zebgop-ops/quadbot/sim/runs/cat/slopes_speed_efficiency.png

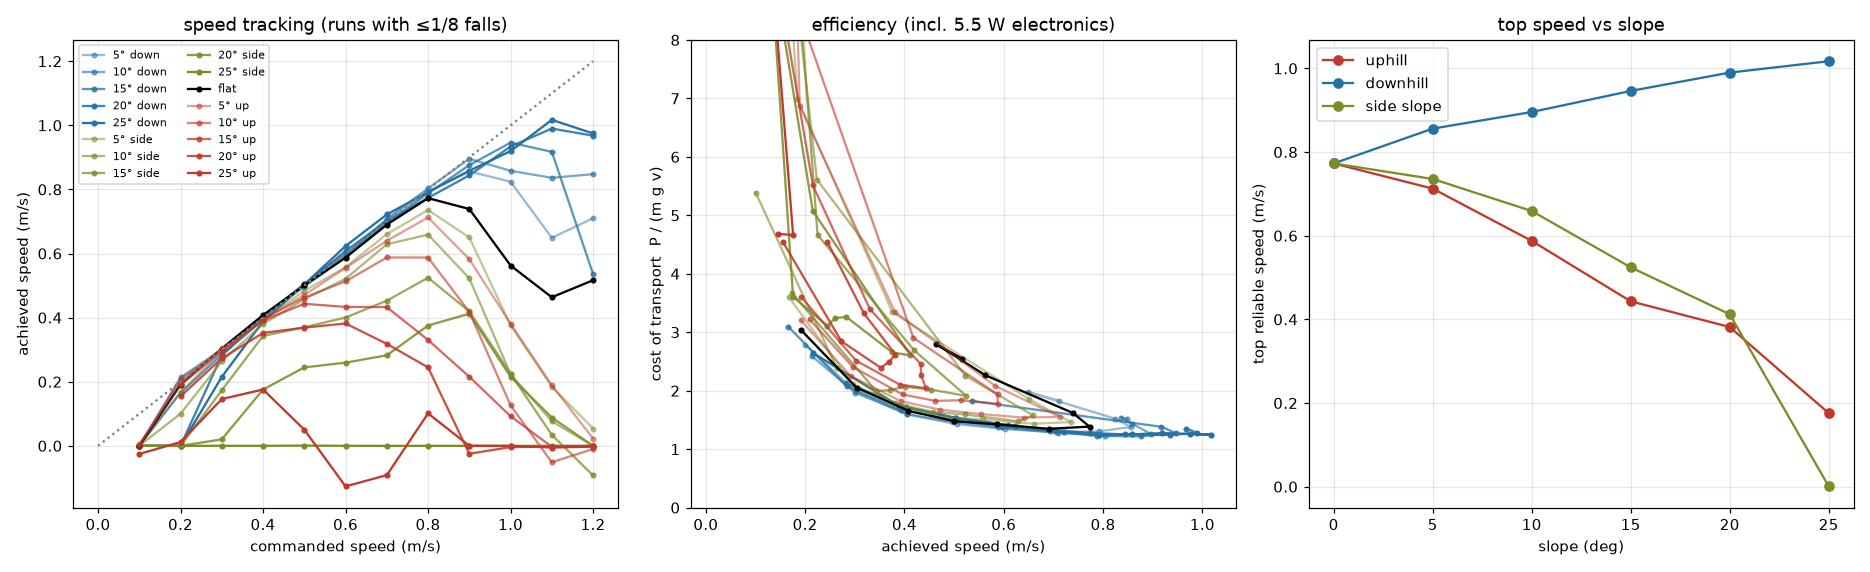
sim/runs/cat/slopes_speed_efficiency.png
