zebgop-ops/quadbot/sim/runs/cat_final/hills_speed_efficiency.png

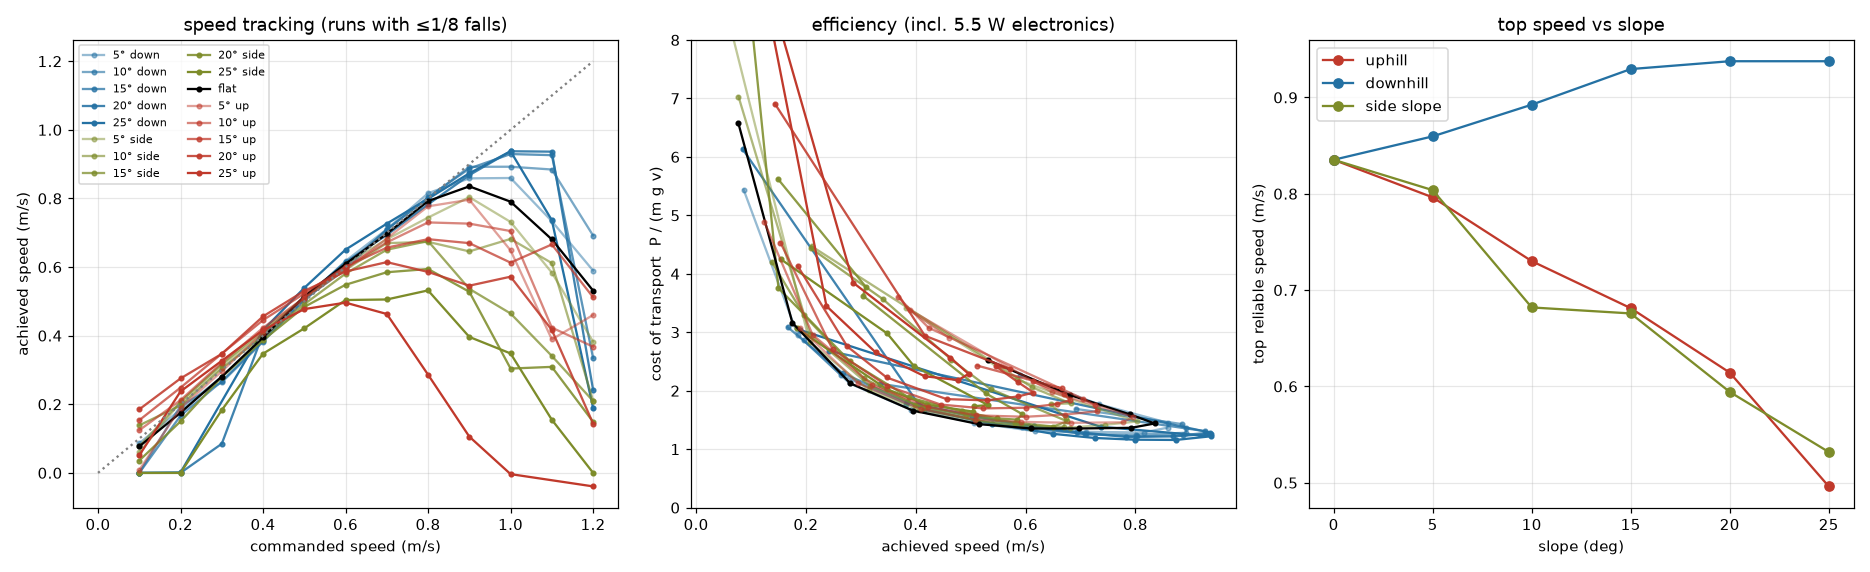
sim/runs/cat_final/hills_speed_efficiency.png
