zebgop-ops/quadbot/sim/quadbot_description/meshes/LR_hip.stl

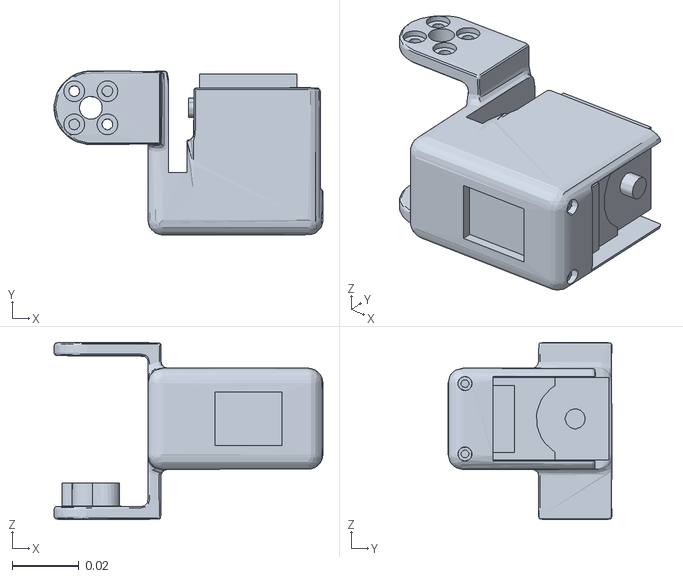
[picture p10: CAD file, 2026-10-11]
sim/quadbot_description/meshes/LR_hip.stl
0.0803 x 0.049 x 0.0529
