zebgop-ops/quadbot/stl/tibia_right.stl

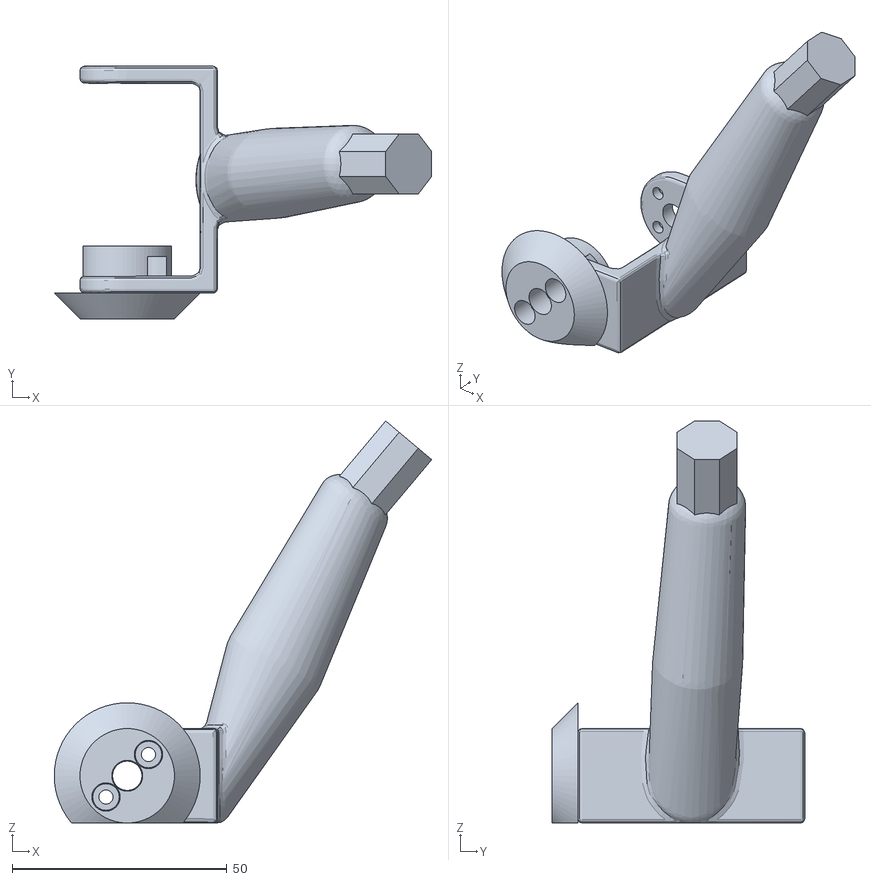
[picture p11: CAD file, 2026-10-11]
stl/tibia_right.stl
87.9 x 58.9 x 93.6
