zebgop-ops/quadbot/sim/quadbot_description/meshes/LF_thigh.stl

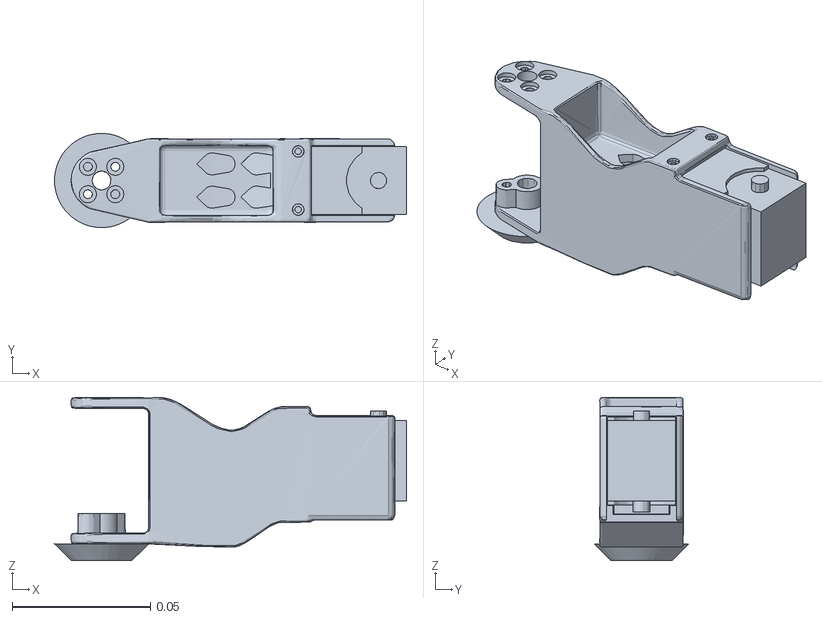
[picture p12: CAD file, 2026-10-11]
sim/quadbot_description/meshes/LF_thigh.stl
0.127 x 0.034 x 0.0589
