zebgop-ops/quadbot/stl/hump.stl

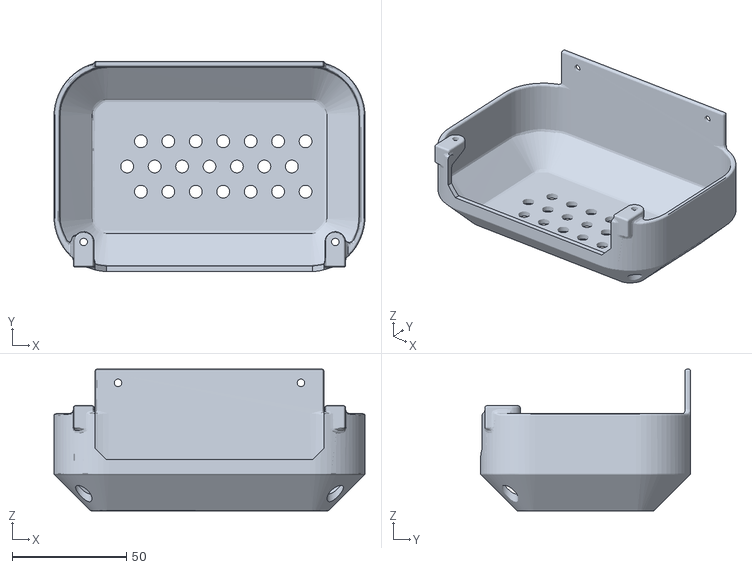
[picture p13: CAD file, 2026-10-11]
stl/hump.stl
136.0 x 92.0 x 62.0
