zebgop-ops/quadbot/stl/foot_left.stl

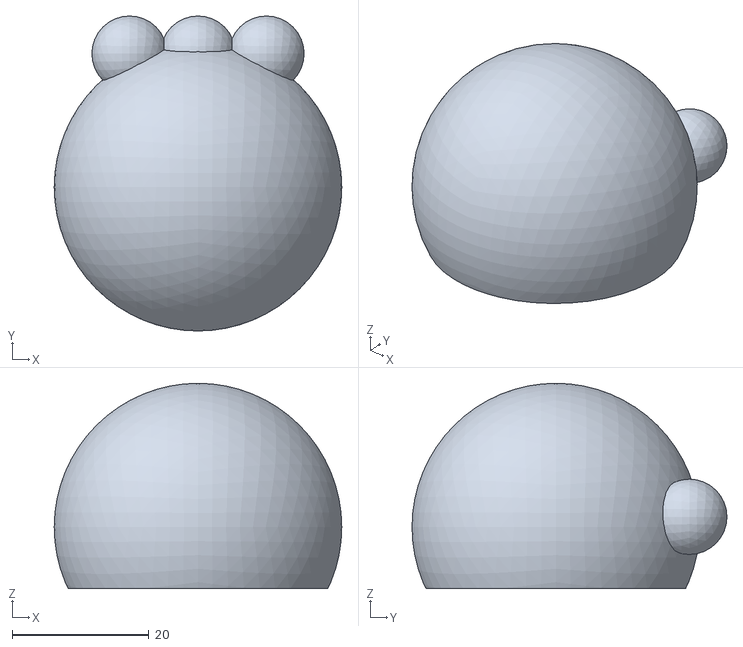
[picture p14: CAD file, 2026-10-11]
stl/foot_left.stl
42.0 x 46.0 x 30.0
