zebgop-ops/quadbot/sim/quadbot_description/meshes/RR_calf.stl

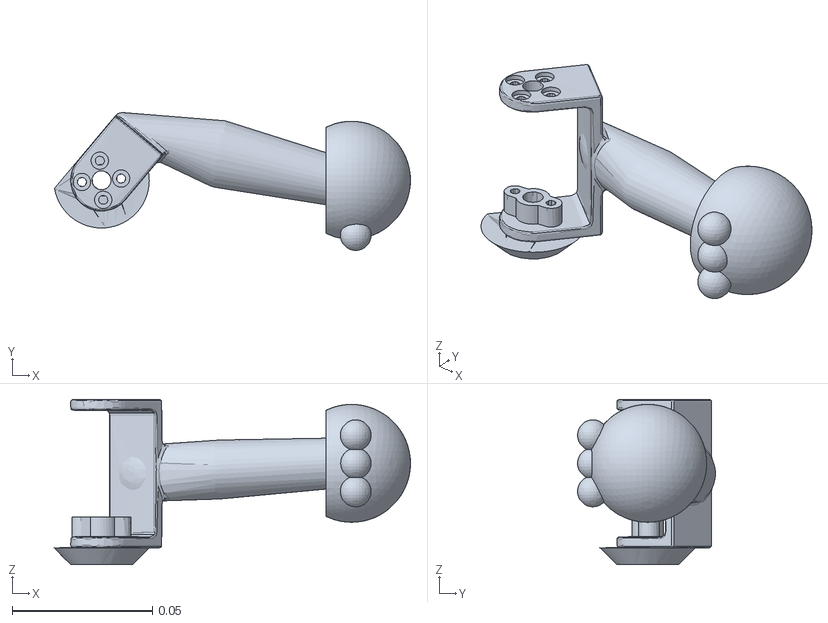
[picture p15: CAD file, 2026-10-11]
sim/quadbot_description/meshes/RR_calf.stl
0.127 x 0.0491 x 0.0589
