zebgop-ops/quadbot/stl/ear_cap.stl

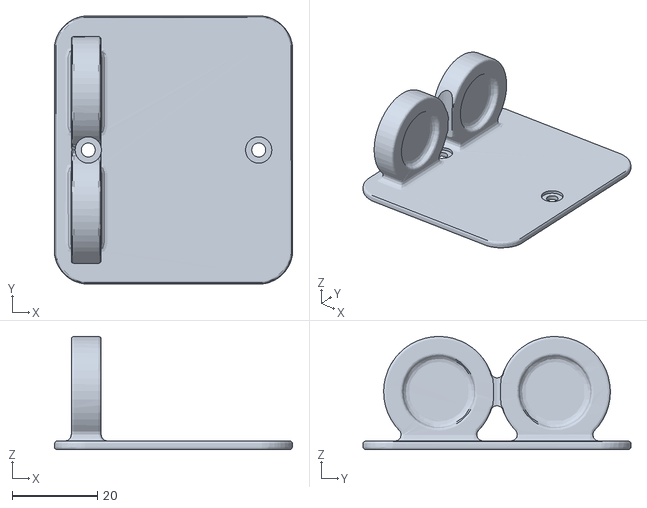
[picture p16: CAD file, 2026-10-11]
stl/ear_cap.stl
55.9 x 62.9 x 26.5
