zebgop-ops/quadbot/stl/neck_base.stl

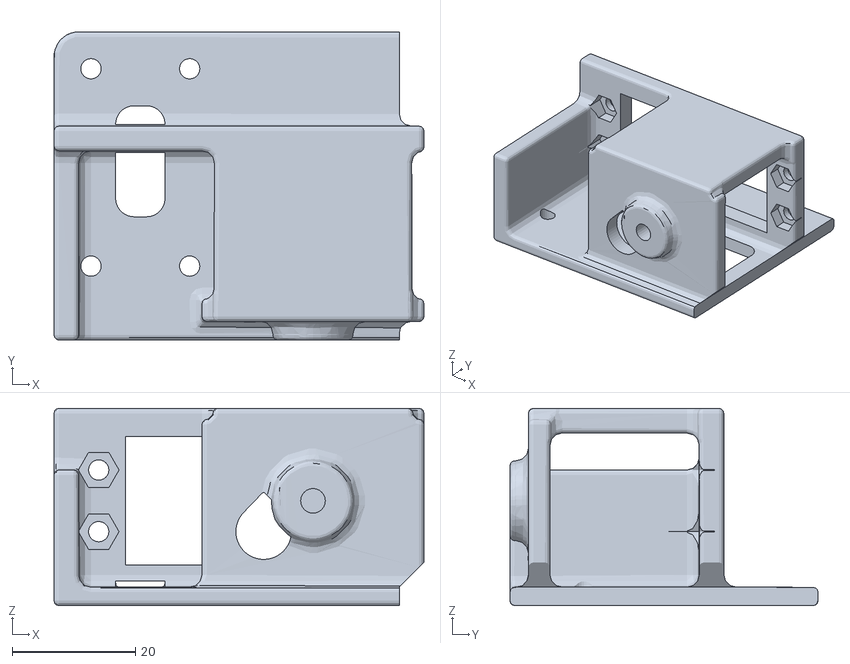
[picture p17: CAD file, 2026-10-11]
stl/neck_base.stl
60.0 x 50.0 x 32.0
