zebgop-ops/quadbot/stl/head.stl

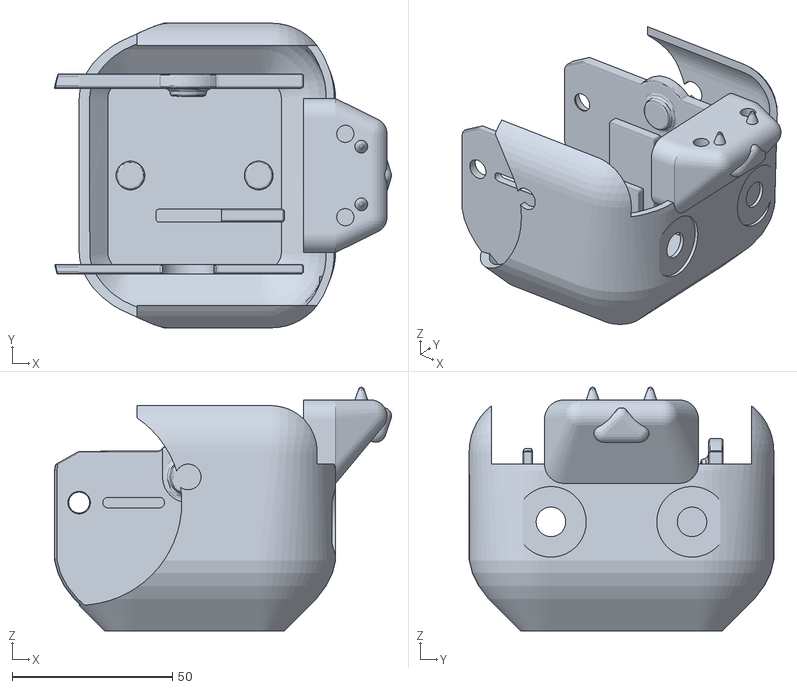
[picture p18: CAD file, 2026-10-11]
stl/head.stl
105.1 x 95.0 x 76.0
