zebgop-ops/quadbot/stl/stand.stl

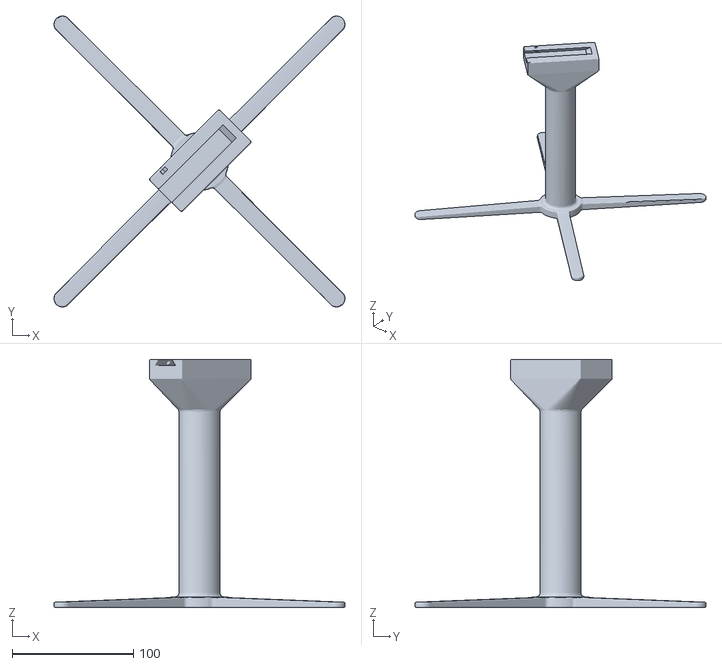
[picture p19: CAD file, 2026-10-11]
stl/stand.stl
240.2 x 240.2 x 205.0
