zebgop-ops/quadbot/stl/fit_test_cradle.stl

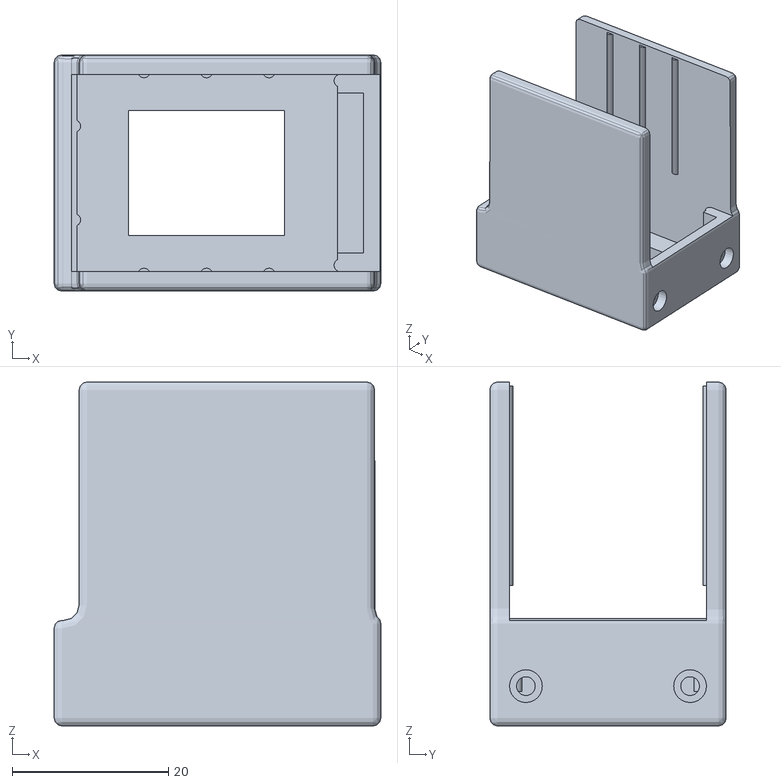
[picture p20: CAD file, 2026-10-11]
stl/fit_test_cradle.stl
41.8 x 30.2 x 44.0
