zebgop-ops/quadbot/stl/jaw.stl

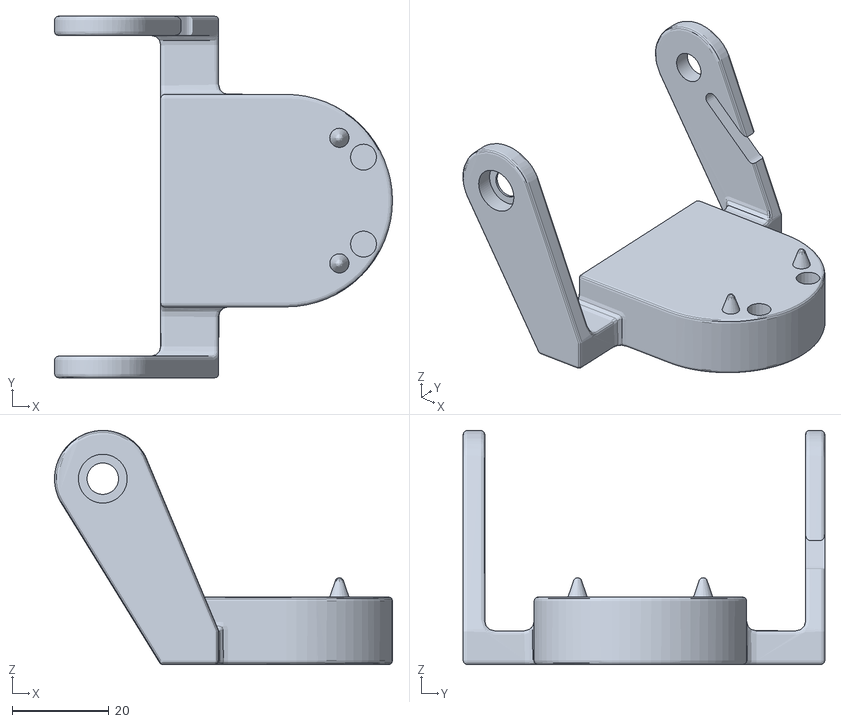
[picture p21: CAD file, 2026-10-11]
stl/jaw.stl
70.0 x 74.9 x 48.5
