zebgop-ops/quadbot/stl/femur.stl

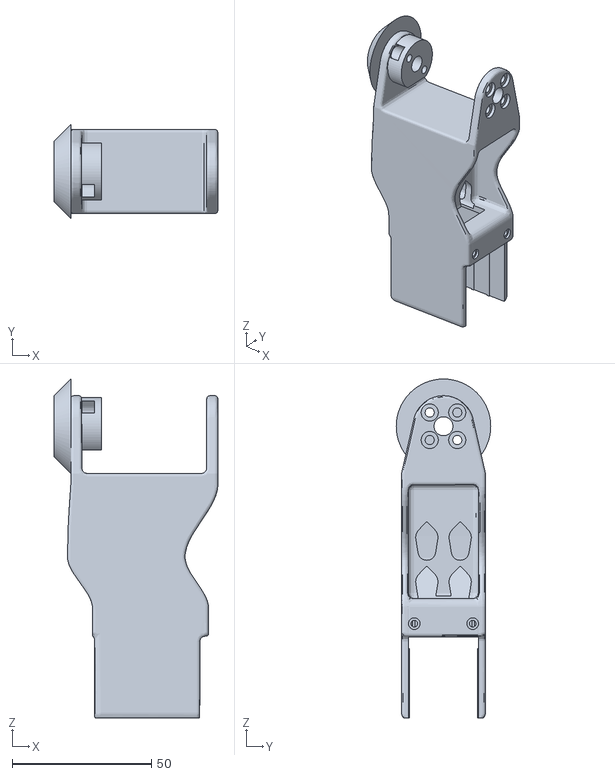
[picture p22: CAD file, 2026-10-11]
stl/femur.stl
58.9 x 34.0 x 121.9
