zebgop-ops/quadbot/sim/quadbot_description/meshes/base.stl

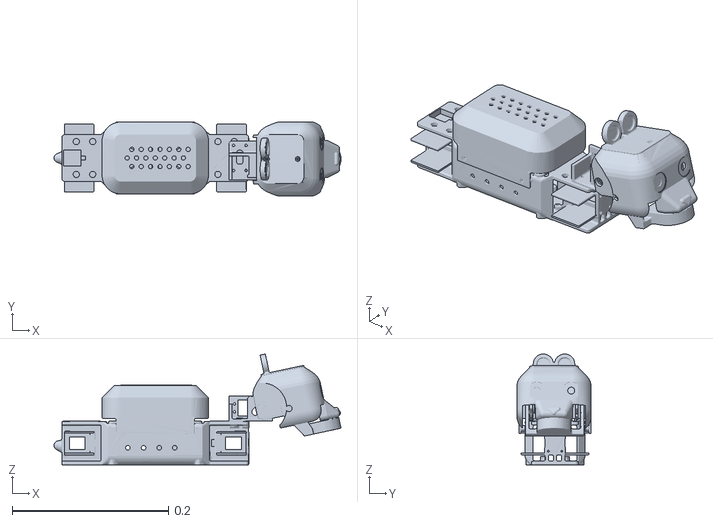
[picture p23: CAD file, 2026-10-11]
sim/quadbot_description/meshes/base.stl
0.367 x 0.095 x 0.142
