zebgop-ops/quadbot/stl/fit_test_hip_roll.stl

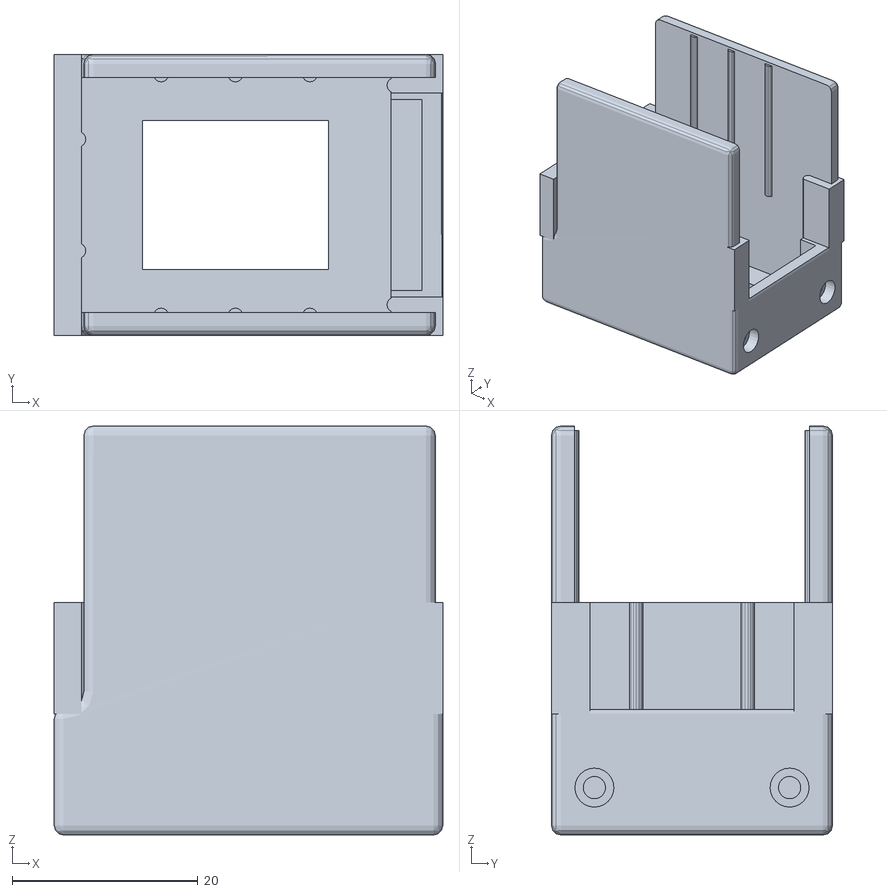
[picture p24: CAD file, 2026-10-11]
stl/fit_test_hip_roll.stl
41.8 x 30.2 x 44.0
