zebgop-ops/quadbot/stl/body_deck.stl

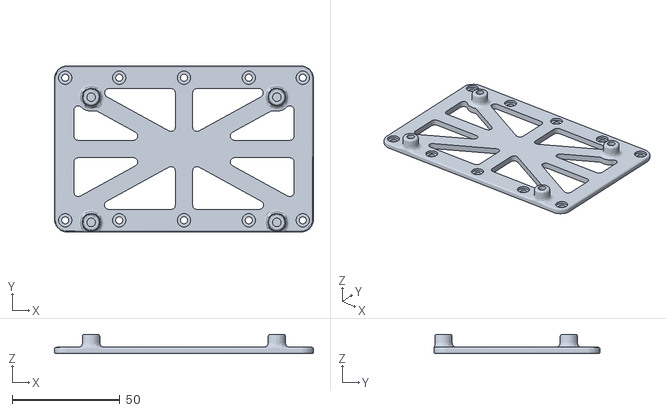
[picture p25: CAD file, 2026-10-11]
stl/body_deck.stl
119.9 x 76.9 x 9.00
