zebgop-ops/quadbot/stl/hip_link.stl

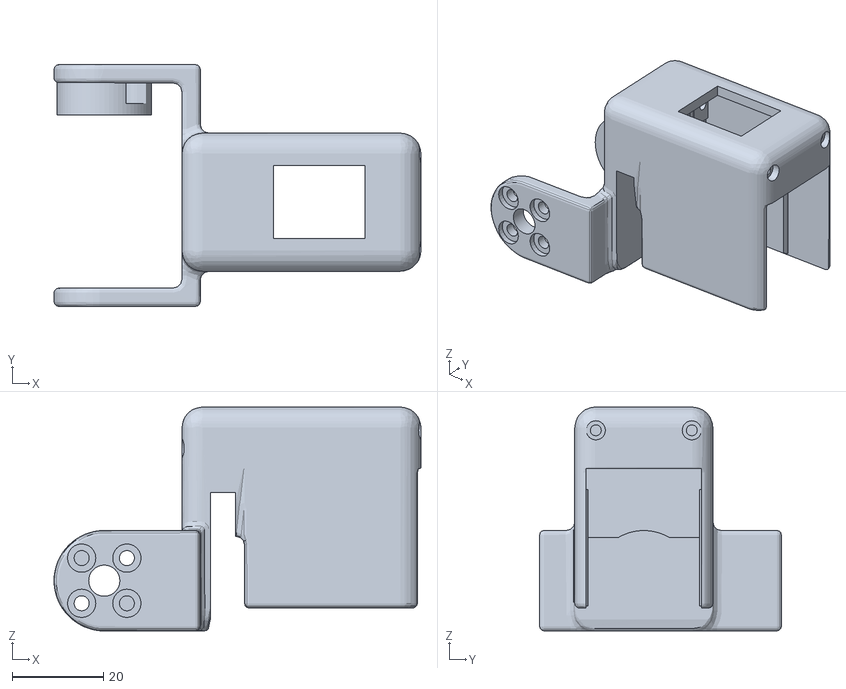
[picture p26: CAD file, 2026-10-11]
stl/hip_link.stl
80.3 x 52.9 x 49.0
