zebgop-ops/quadbot/stl/body.stl

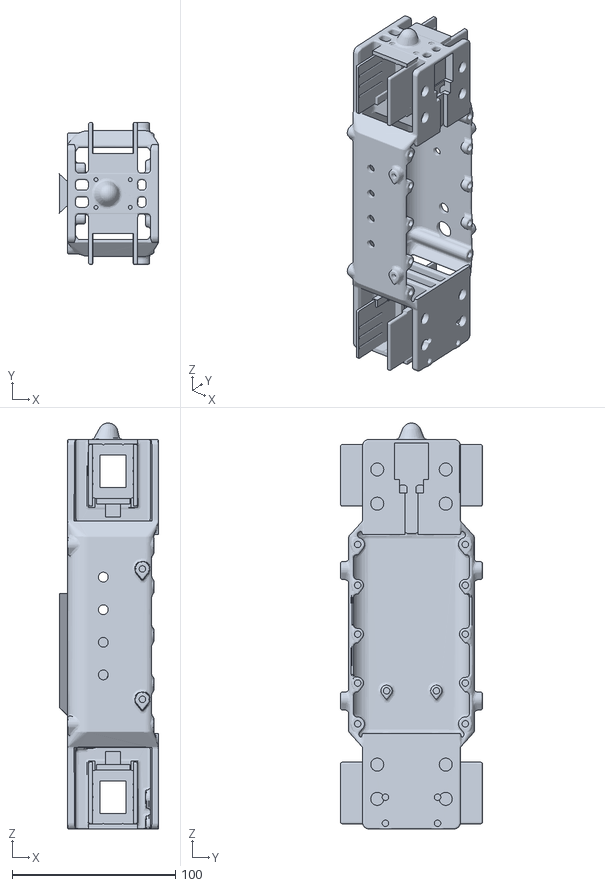
[picture p27: CAD file, 2026-10-11]
stl/body.stl
61.0 x 87.0 x 249.0
