zebgop-ops/quadbot/stl/fit_test_bracket.stl

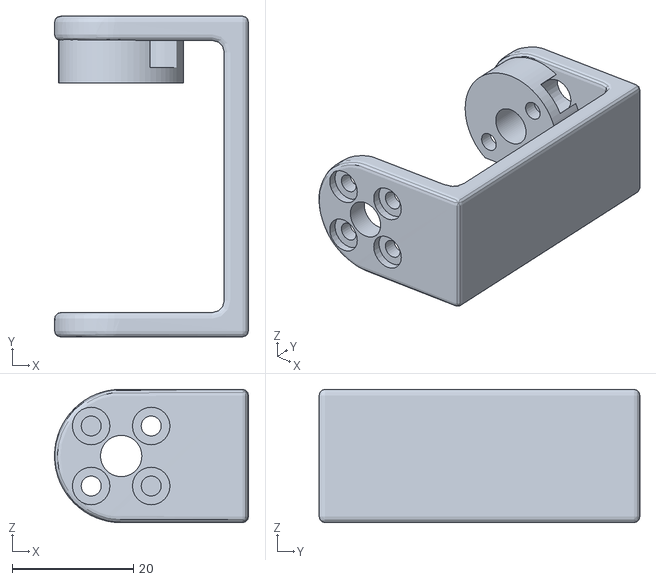
[picture p28: CAD file, 2026-10-11]
stl/fit_test_bracket.stl
32.0 x 52.9 x 22.0
