zebgop-ops/quadbot/(list of files, cad)

Other CAD files:
sim/quadbot_description/meshes/RR_hip.stl
stl/tibia_left.stl
sim/quadbot_description/meshes/LF_hip.stl
sim/quadbot_description/meshes/LF_calf.stl
sim/quadbot_description/meshes/LR_calf.stl
stl/foot_right.stl
stl/hip_link_mirror.stl
quadbot.blend
