zebgop-ops/quadbot/docs/wiring.html

Drawing

# Quadbot Wiring

12 × STS3215-12V legs · Jetson Nano 2GB · Betaflight F3 · 2 × DS3218 head

RevA

Date2026-09-24

Supply3S2P 21700
9.0–12.6 V

Sheet1 / 1

## Schematic

Each coloured power line is a supply pair: plus and minus run together, and every ground meets at the battery negative. Ground-only links are drawn dashed. Click a wire type below to trace it.

12 V battery 5 V Jetson 6 V head servos Servo bus data USB PWM signal Ground link UART / I²C Camera ribbon Showing all wires

Servo power never goes through the bus adapter. Run only DATA and GND from the adapter to the hub, and leave its V+ pin unconnected. Twelve servos peak at 10–15 A, far past what the adapter board carries.

Power
From | To | Wire | Notes
Battery | Main switch + 20 A fuse | 14 AWG | XT60 at the pack
Fuse | F3 battery pads | 14 AWG | Also sets the F3's battery-voltage reading
F3 ESC pads | Servo switch → hub | 16 AWG | After the shunt: this is the current the F3 measures
Hub | Each leg's hip-roll servo | 18 AWG | One feed per leg; 5264 connectors carry ~3 A, so never chain legs together
Battery side | 5 V buck | 18 AWG | Before the shunt, so the reading stays locomotion power only
5 V buck | Jetson USB-C | USB-C lead | ≥ 4 A; set it to 5.1 V before connecting
Battery side | 6 V BEC | 18 AWG | Head servos stall near 3 A each
6 V BEC | Neck + jaw servo V+ | 20 AWG | Never from the Jetson's 5 V pins

Jetson connections
Jetson | To | Signal
USB-C | 5 V buck | Power in
USB-A | Betaflight F3 | MSP · /dev/serial/by-id/usb-STMicroelectronics_STM32_Virtual_COM_Port_206438634634-if00copy
USB-A | Bus servo adapter | STS bus, 1 Mbps · /dev/ttyACM* (Waveshare) or /dev/ttyUSB* (FE-URT-1)
pin 32 | Neck servo signal | PWM0 · pwmchip0/pwm0 · optional 470 Ω in series
pin 33 | Jaw servo signal | PWM2 · pwmchip0/pwm2 · optional 470 Ω in series
pin 30 / 34 | 6 V BEC − | Common ground for the PWM signals
pin 8 | GNSS RX | UART TX · /dev/ttyTHS1
pin 10 | GNSS TX | UART RX
pin 3 / 5 | Compass SDA / SCL | I²C bus 1
pin 1 / 6 | GNSS VCC / GND | 3.3 V, check your module's label
CSI | IMX219 camera | Ribbon, with a service loop at the neck

Servo IDs (set before fitting horns)
Leg | Hip roll | Hip pitch | Knee
LF · front left | 1 | 2 | 3
RF · front right | 4 | 5 | 6
LR · rear left | 7 | 8 | 9
RR · rear right | 10 | 11 | 12

## Before first power-up

- Continuity-test every supply pair for shorts, and check polarity at each connector.
- Set the 5 V buck to 5.1 V and the BEC to 6.0 V on a meter before the Jetson or servos are attached.
- All grounds meet at the battery negative, including the adapter GND and Jetson pin 30/34.
- The adapter's V+ is not connected to the servo bus.
- Servo switch OFF for the first boot. Then turn it on and run calibrate.py scan, which should find all 12 IDs.
- Check the F3 shows the pack voltage in f3_tool.py … info and near 0 A with the servos idle.
