zebgop-ops/quadbot/sim/quadbot_description/urdf/quadbot.urdf

<?xml version="1.0"?>
<robot name="quadbot">
<material name="honey"><color rgba="0.80 0.50 0.22 1"/></material>
<link name="base_link"><inertial><origin xyz="0.024688 0.000011 0.014186" rpy="0 0 0"/><mass value="1.26486"/><inertia ixx="1.682e-03" ixy="-7.061e-06" ixz="-1.365e-03" iyy="9.724e-03" iyz="-1.812e-06" izz="9.289e-03"/></inertial><visual><geometry><mesh filename="package://quadbot_description/meshes/base.stl"/></geometry><material name="honey"/></visual><collision><origin xyz="0.0000 0.0000 0.0000" rpy="0 0 0"/><geometry><box size="0.2400 0.0770 0.0560"/></geometry></collision><collision><origin xyz="0.0000 0.0000 0.0510" rpy="0 0 0"/><geometry><box size="0.1360 0.0920 0.0460"/></geometry></collision><collision><origin xyz="0.1796 -0.0013 0.0563" rpy="0 0 0"/><geometry><box size="0.1100 0.0950 0.0900"/></geometry></collision></link>
<link name="LF_hip"><inertial><origin xyz="0.042858 0.013014 -0.000413" rpy="0 0 0"/><mass value="0.07246"/><inertia ixx="1.983e-05" ixy="-1.628e-06" ixz="-1.051e-06" iyy="2.064e-05" iyz="-3.901e-07" izz="2.742e-05"/></inertial><visual><geometry><mesh filename="package://quadbot_description/meshes/LF_hip.stl"/></geometry><material name="honey"/></visual><collision><origin xyz="0.0300 0.0120 0" rpy="0 0 0"/><geometry><box size="0.05 0.05 0.045"/></geometry></collision></link>
<link name="LF_thigh"><inertial><origin xyz="0.072954 0.000000 -0.002494" rpy="0 0 0"/><mass value="0.07993"/><inertia ixx="1.780e-05" ixy="5.267e-09" ixz="-9.248e-06" iyy="8.055e-05" iyz="-3.026e-10" izz="7.424e-05"/></inertial><visual><geometry><mesh filename="package://quadbot_description/meshes/LF_thigh.stl"/></geometry><material name="honey"/></visual><collision><origin xyz="0.0500 0 -0.004" rpy="0 0 0"/><geometry><box size="0.1300 0.034 0.05"/></geometry></collision></link>
<link name="LF_calf"><inertial><origin xyz="0.057937 -0.004160 -0.003126" rpy="0 0 0"/><mass value="0.03525"/><inertia ixx="8.916e-06" ixy="-4.926e-06" ixz="-5.255e-06" iyy="4.964e-05" iyz="5.034e-08" izz="4.753e-05"/></inertial><visual><geometry><mesh filename="package://quadbot_description/meshes/LF_calf.stl"/></geometry><material name="honey"/></visual><collision><origin xyz="0.0445 0 0" rpy="0 1.570796 0"/><geometry><cylinder radius="0.011" length="0.0690"/></geometry></collision></link>
<link name="LF_foot"><inertial><origin xyz="0 0 0"/><mass value="0.001"/><inertia ixx="1e-8" ixy="0" ixz="0" iyy="1e-8" iyz="0" izz="1e-8"/></inertial><collision><geometry><sphere radius="0.0210"/></geometry></collision></link>
<link name="RF_hip"><inertial><origin xyz="0.042858 -0.013014 -0.000413" rpy="0 0 0"/><mass value="0.07246"/><inertia ixx="1.983e-05" ixy="1.628e-06" ixz="-1.051e-06" iyy="2.064e-05" iyz="3.901e-07" izz="2.742e-05"/></inertial><visual><geometry><mesh filename="package://quadbot_description/meshes/RF_hip.stl"/></geometry><material name="honey"/></visual><collision><origin xyz="0.0300 -0.0120 0" rpy="0 0 0"/><geometry><box size="0.05 0.05 0.045"/></geometry></collision></link>
<link name="RF_thigh"><inertial><origin xyz="0.072954 0.000000 -0.002494" rpy="0 0 0"/><mass value="0.07993"/><inertia ixx="1.780e-05" ixy="5.267e-09" ixz="-9.248e-06" iyy="8.055e-05" iyz="-3.026e-10" izz="7.424e-05"/></inertial><visual><geometry><mesh filename="package://quadbot_description/meshes/RF_thigh.stl"/></geometry><material name="honey"/></visual><collision><origin xyz="0.0500 0 -0.004" rpy="0 0 0"/><geometry><box size="0.1300 0.034 0.05"/></geometry></collision></link>
<link name="RF_calf"><inertial><origin xyz="0.057937 0.004160 -0.003126" rpy="0 0 0"/><mass value="0.03525"/><inertia ixx="8.916e-06" ixy="4.926e-06" ixz="-5.255e-06" iyy="4.964e-05" iyz="-5.034e-08" izz="4.753e-05"/></inertial><visual><geometry><mesh filename="package://quadbot_description/meshes/RF_calf.stl"/></geometry><material name="honey"/></visual><collision><origin xyz="0.0445 0 0" rpy="0 1.570796 0"/><geometry><cylinder radius="0.011" length="0.0690"/></geometry></collision></link>
<link name="RF_foot"><inertial><origin xyz="0 0 0"/><mass value="0.001"/><inertia ixx="1e-8" ixy="0" ixz="0" iyy="1e-8" iyz="0" izz="1e-8"/></inertial><collision><geometry><sphere radius="0.0210"/></geometry></collision></link>
<link name="LR_hip"><inertial><origin xyz="0.042858 -0.013014 -0.000413" rpy="0 0 0"/><mass value="0.07246"/><inertia ixx="1.983e-05" ixy="1.628e-06" ixz="-1.051e-06" iyy="2.064e-05" iyz="3.901e-07" izz="2.742e-05"/></inertial><visual><geometry><mesh filename="package://quadbot_description/meshes/LR_hip.stl"/></geometry><material name="honey"/></visual><collision><origin xyz="0.0300 -0.0120 0" rpy="0 0 0"/><geometry><box size="0.05 0.05 0.045"/></geometry></collision></link>
<link name="LR_thigh"><inertial><origin xyz="0.072954 0.000000 -0.002494" rpy="0 0 0"/><mass value="0.07993"/><inertia ixx="1.780e-05" ixy="5.267e-09" ixz="-9.248e-06" iyy="8.055e-05" iyz="-3.026e-10" izz="7.424e-05"/></inertial><visual><geometry><mesh filename="package://quadbot_description/meshes/LR_thigh.stl"/></geometry><material name="honey"/></visual><collision><origin xyz="0.0500 0 -0.004" rpy="0 0 0"/><geometry><box size="0.1300 0.034 0.05"/></geometry></collision></link>
<link name="LR_calf"><inertial><origin xyz="0.057937 -0.004160 -0.003126" rpy="0 0 0"/><mass value="0.03525"/><inertia ixx="8.916e-06" ixy="-4.926e-06" ixz="-5.255e-06" iyy="4.964e-05" iyz="5.034e-08" izz="4.753e-05"/></inertial><visual><geometry><mesh filename="package://quadbot_description/meshes/LR_calf.stl"/></geometry><material name="honey"/></visual><collision><origin xyz="0.0445 0 0" rpy="0 1.570796 0"/><geometry><cylinder radius="0.011" length="0.0690"/></geometry></collision></link>
<link name="LR_foot"><inertial><origin xyz="0 0 0"/><mass value="0.001"/><inertia ixx="1e-8" ixy="0" ixz="0" iyy="1e-8" iyz="0" izz="1e-8"/></inertial><collision><geometry><sphere radius="0.0210"/></geometry></collision></link>
<link name="RR_hip"><inertial><origin xyz="0.042858 0.013014 -0.000413" rpy="0 0 0"/><mass value="0.07246"/><inertia ixx="1.983e-05" ixy="-1.628e-06" ixz="-1.051e-06" iyy="2.064e-05" iyz="-3.901e-07" izz="2.742e-05"/></inertial><visual><geometry><mesh filename="package://quadbot_description/meshes/RR_hip.stl"/></geometry><material name="honey"/></visual><collision><origin xyz="0.0300 0.0120 0" rpy="0 0 0"/><geometry><box size="0.05 0.05 0.045"/></geometry></collision></link>
<link name="RR_thigh"><inertial><origin xyz="0.072954 0.000000 -0.002494" rpy="0 0 0"/><mass value="0.07993"/><inertia ixx="1.780e-05" ixy="5.267e-09" ixz="-9.248e-06" iyy="8.055e-05" iyz="-3.026e-10" izz="7.424e-05"/></inertial><visual><geometry><mesh filename="package://quadbot_description/meshes/RR_thigh.stl"/></geometry><material name="honey"/></visual><collision><origin xyz="0.0500 0 -0.004" rpy="0 0 0"/><geometry><box size="0.1300 0.034 0.05"/></geometry></collision></link>
<link name="RR_calf"><inertial><origin xyz="0.057937 0.004160 -0.003126" rpy="0 0 0"/><mass value="0.03525"/><inertia ixx="8.916e-06" ixy="4.926e-06" ixz="-5.255e-06" iyy="4.964e-05" iyz="-5.034e-08" izz="4.753e-05"/></inertial><visual><geometry><mesh filename="package://quadbot_description/meshes/RR_calf.stl"/></geometry><material name="honey"/></visual><collision><origin xyz="0.0445 0 0" rpy="0 1.570796 0"/><geometry><cylinder radius="0.011" length="0.0690"/></geometry></collision></link>
<link name="RR_foot"><inertial><origin xyz="0 0 0"/><mass value="0.001"/><inertia ixx="1e-8" ixy="0" ixz="0" iyy="1e-8" iyz="0" izz="1e-8"/></inertial><collision><geometry><sphere radius="0.0210"/></geometry></collision></link>
<joint name="LF_hip_roll" type="revolute"><parent link="base_link"/><child link="LF_hip"/><origin xyz="0.100000 0.037500 0.000000" rpy="1.570796 0.000000 1.570796"/><axis xyz="0 0 1"/><limit lower="-1.0472" upper="0.8727" effort="2.9" velocity="4.7"/><dynamics damping="0.05" friction="0.02"/></joint>
<joint name="LF_hip_pitch" type="revolute"><parent link="LF_hip"/><child link="LF_thigh"/><origin xyz="0.047000 0.000000 0.000000" rpy="1.570796 0.000000 -1.570796"/><axis xyz="0 0 1"/><limit lower="-1.6581" upper="1.6581" effort="2.9" velocity="4.7"/><dynamics damping="0.05" friction="0.02"/></joint>
<joint name="LF_knee" type="revolute"><parent link="LF_thigh"/><child link="LF_calf"/><origin xyz="0.100000 0.000000 0.000000" rpy="0.000000 0.000000 0.000000"/><axis xyz="0 0 1"/><limit lower="-0.7854" upper="2.5307" effort="2.9" velocity="4.7"/><dynamics damping="0.05" friction="0.02"/></joint>
<joint name="LF_foot_fixed" type="fixed"><parent link="LF_calf"/><child link="LF_foot"/><origin xyz="0.089000 0.000000 0.000000" rpy="0.000000 0.000000 0.000000"/></joint>
<joint name="RF_hip_roll" type="revolute"><parent link="base_link"/><child link="RF_hip"/><origin xyz="0.100000 -0.037500 0.000000" rpy="-1.570796 0.000000 -1.570796"/><axis xyz="0 0 1"/><limit lower="-0.6981" upper="1.0472" effort="2.9" velocity="4.7"/><dynamics damping="0.05" friction="0.02"/></joint>
<joint name="RF_hip_pitch" type="revolute"><parent link="RF_hip"/><child link="RF_thigh"/><origin xyz="0.047000 0.000000 0.000000" rpy="-1.570796 0.000000 1.570796"/><axis xyz="0 0 1"/><limit lower="-1.6581" upper="1.6581" effort="2.9" velocity="4.7"/><dynamics damping="0.05" friction="0.02"/></joint>
<joint name="RF_knee" type="revolute"><parent link="RF_thigh"/><child link="RF_calf"/><origin xyz="0.100000 0.000000 0.000000" rpy="0.000000 0.000000 0.000000"/><axis xyz="0 0 1"/><limit lower="-2.5307" upper="0.7854" effort="2.9" velocity="4.7"/><dynamics damping="0.05" friction="0.02"/></joint>
<joint name="RF_foot_fixed" type="fixed"><parent link="RF_calf"/><child link="RF_foot"/><origin xyz="0.089000 0.000000 0.000000" rpy="0.000000 0.000000 0.000000"/></joint>
<joint name="LR_hip_roll" type="revolute"><parent link="base_link"/><child link="LR_hip"/><origin xyz="-0.100000 0.037500 0.000000" rpy="-1.570796 0.000000 1.570796"/><axis xyz="0 0 1"/><limit lower="-0.8727" upper="1.0472" effort="2.9" velocity="4.7"/><dynamics damping="0.05" friction="0.02"/></joint>
<joint name="LR_hip_pitch" type="revolute"><parent link="LR_hip"/><child link="LR_thigh"/><origin xyz="0.047000 0.000000 0.000000" rpy="-1.570796 0.000000 1.570796"/><axis xyz="0 0 1"/><limit lower="-1.6581" upper="1.6581" effort="2.9" velocity="4.7"/><dynamics damping="0.05" friction="0.02"/></joint>
<joint name="LR_knee" type="revolute"><parent link="LR_thigh"/><child link="LR_calf"/><origin xyz="0.100000 0.000000 0.000000" rpy="0.000000 0.000000 0.000000"/><axis xyz="0 0 1"/><limit lower="-0.7854" upper="2.5307" effort="2.9" velocity="4.7"/><dynamics damping="0.05" friction="0.02"/></joint>
<joint name="LR_foot_fixed" type="fixed"><parent link="LR_calf"/><child link="LR_foot"/><origin xyz="0.089000 0.000000 0.000000" rpy="0.000000 0.000000 0.000000"/></joint>
<joint name="RR_hip_roll" type="revolute"><parent link="base_link"/><child link="RR_hip"/><origin xyz="-0.100000 -0.037500 0.000000" rpy="1.570796 0.000000 -1.570796"/><axis xyz="0 0 1"/><limit lower="-1.0472" upper="0.8727" effort="2.9" velocity="4.7"/><dynamics damping="0.05" friction="0.02"/></joint>
<joint name="RR_hip_pitch" type="revolute"><parent link="RR_hip"/><child link="RR_thigh"/><origin xyz="0.047000 0.000000 0.000000" rpy="1.570796 0.000000 -1.570796"/><axis xyz="0 0 1"/><limit lower="-1.6581" upper="1.6581" effort="2.9" velocity="4.7"/><dynamics damping="0.05" friction="0.02"/></joint>
<joint name="RR_knee" type="revolute"><parent link="RR_thigh"/><child link="RR_calf"/><origin xyz="0.100000 0.000000 0.000000" rpy="0.000000 0.000000 0.000000"/><axis xyz="0 0 1"/><limit lower="-2.5307" upper="0.7854" effort="2.9" velocity="4.7"/><dynamics damping="0.05" friction="0.02"/></joint>
<joint name="RR_foot_fixed" type="fixed"><parent link="RR_calf"/><child link="RR_foot"/><origin xyz="0.089000 0.000000 0.000000" rpy="0.000000 0.000000 0.000000"/></joint>
</robot>
