zebgop-ops/quadbot/(commit log)

2026-10-11 Quadbot: 12-DOF quadruped (STS3215, Jetson Nano 2GB)
    Parametric CAD (manifold3d) with print-oriented STLs and design checks,
    Isaac Lab training tasks and the trained "cat" gait policy, and the
    Jetson runtime (servo bus, Betaflight F3 IMU, neck/jaw PWM, calibration).
    [LF_calf.stl, LF_hip.stl, LF_thigh.stl, LR_calf.stl, LR_hip.stl, LR_thigh.stl, RF_calf.stl, RF_hip.stl]
2026-10-11 README: Cycles renders and a training GIF
    Fresh renders of the current cub design (Blender Cycles with bounce light, a
    shadowless fill and AgX, so the shadow sides keep their detail), an 8 s GIF
    of the trained gait on the Isaac Lab terrain, and links to the full videos.
    The pre-cub renders are no longer tracked.
2026-10-11 Wiring diagram: PNG preview in the README, served via GitHub Pages
